ThrudTheBarbarian/xe-host/README.md

# xe-host
T8-based Atari-XE host-interface to XIO
