ThrudTheBarbarian/xe-host/host.brd

## EAGLE design host.brd (2021-09-28)

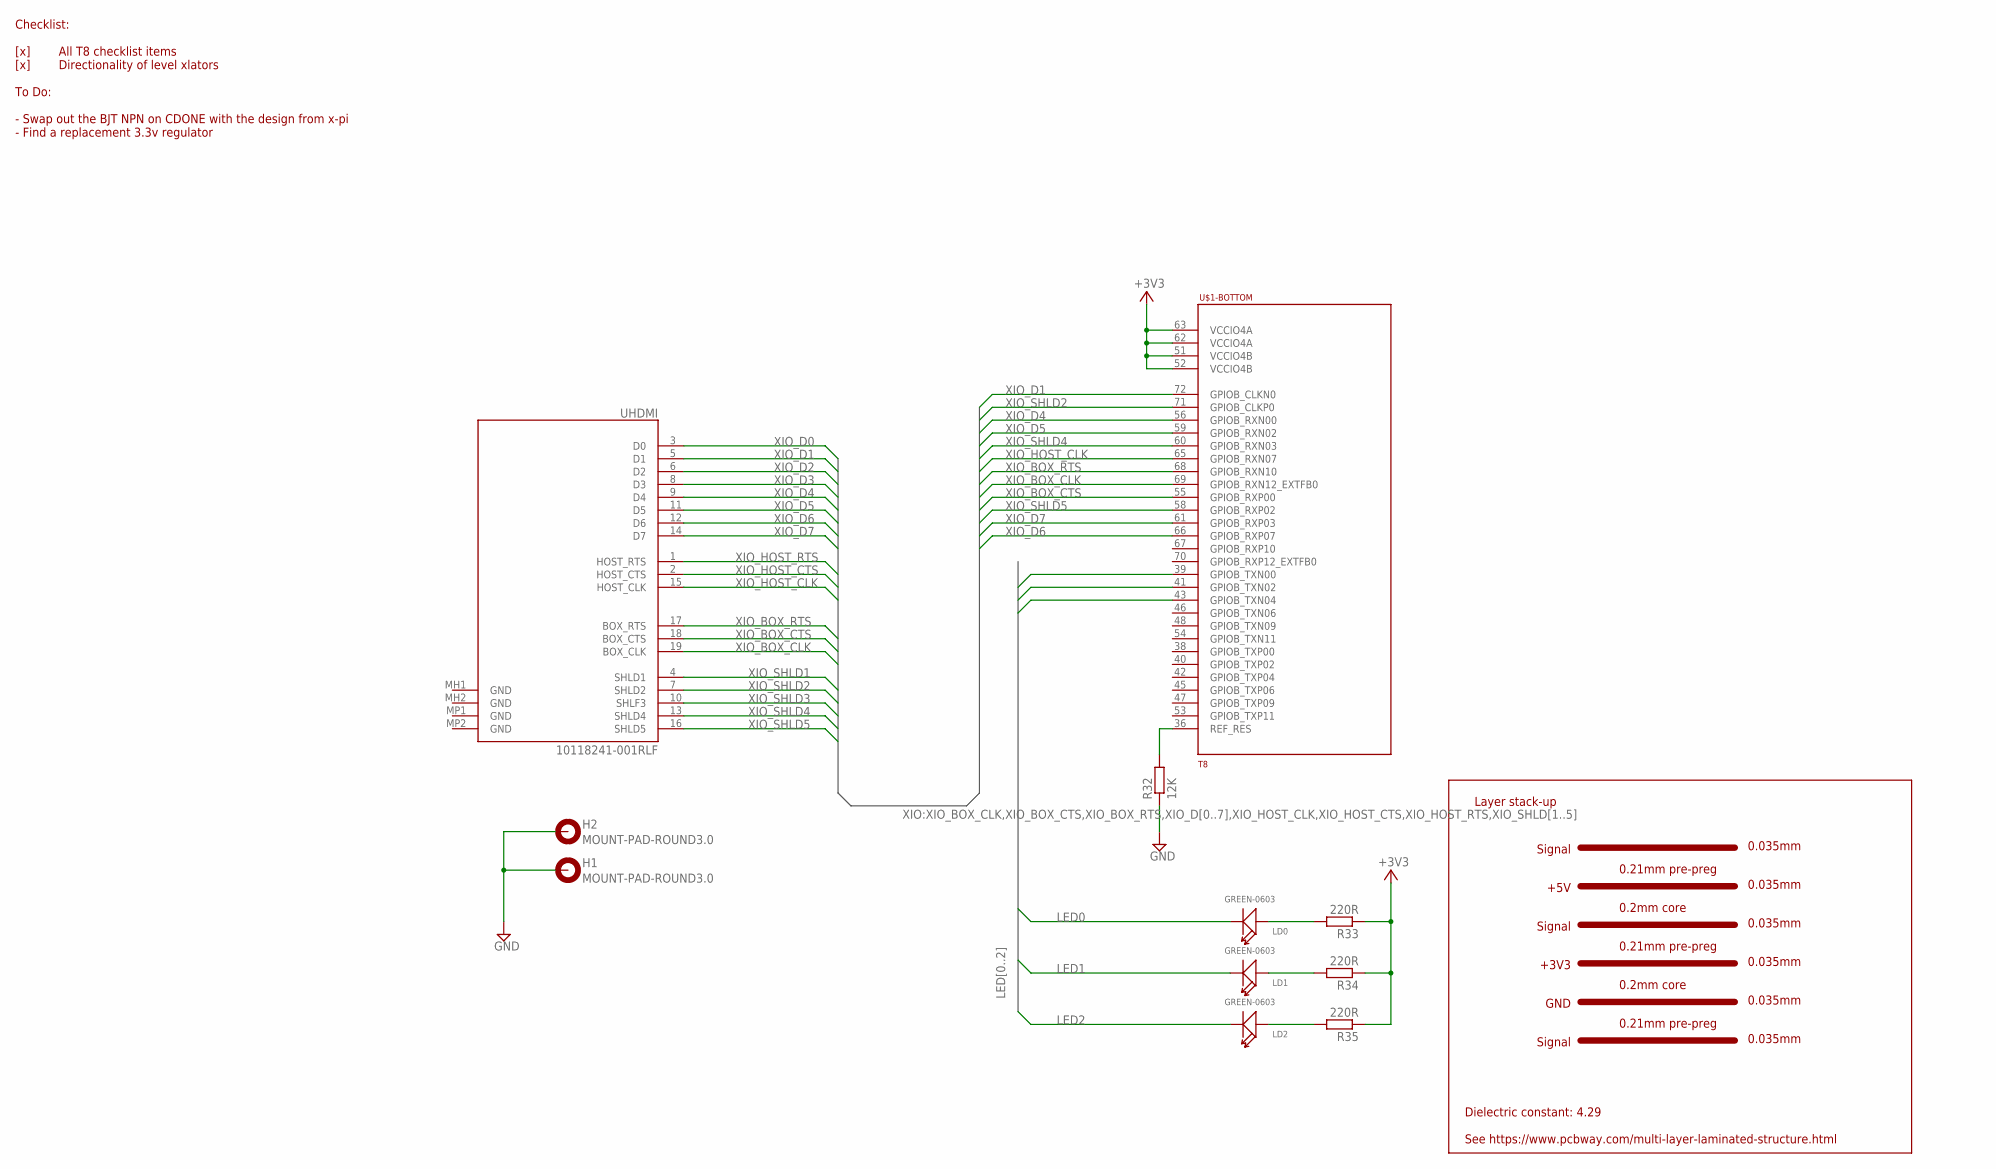
[picture p1: schematic host.sch, sheet 1]

Parts:
H1, H2: MOUNT-PAD-ROUND3.0; 3,0-PAD
LD0, LD1, LD2: GREEN-0603; LED-0603
R32: 12K; R0201
R33, R34, R35: 220R; R0201
U$1: T8; TQFP144
UHDMI: 10118241-001RLF; 10118241001RLF

Connections:
+3V3: R33.1, R34.1, R35.1, U$1.51 (VCCIO4B), U$1.52 (VCCIO4B), U$1.62 (VCCIO4A), U$1.63 (VCCIO4A); also elsewhere on the board
GND: H1.B3,0, H2.B3,0, R32.1; also elsewhere on the board
LED0: LD0.-, U$1.39 (GPIOB_TXN00)
LED1: LD1.-, U$1.41 (GPIOB_TXN02)
LED2: LD2.-, U$1.43 (GPIOB_TXN04)
unnamed: R32.2, U$1.36 (REF_RES)
unnamed: LD0.+, R33.2
unnamed: LD1.+, R34.2
unnamed: LD2.+, R35.2
XIO_BOX_CLK: U$1.69 (GPIOB_RXN12_EXTFB0), UHDMI.19 (BOX_CLK); also elsewhere on the board
XIO_BOX_CTS: U$1.55 (GPIOB_RXP00), UHDMI.18 (BOX_CTS); also elsewhere on the board
XIO_BOX_RTS: U$1.68 (GPIOB_RXN10), UHDMI.17 (BOX_RTS); also elsewhere on the board
XIO_D0: UHDMI.3 (D0); also elsewhere on the board
XIO_D1: U$1.72 (GPIOB_CLKN0), UHDMI.5 (D1); also elsewhere on the board
XIO_D2: UHDMI.6 (D2); also elsewhere on the board
XIO_D3: UHDMI.8 (D3); also elsewhere on the board
XIO_D4: U$1.56 (GPIOB_RXN00), UHDMI.9 (D4); also elsewhere on the board
XIO_D5: U$1.59 (GPIOB_RXN02), UHDMI.11 (D5); also elsewhere on the board
XIO_D6: U$1.66 (GPIOB_RXP07), UHDMI.12 (D6); also elsewhere on the board
XIO_D7: U$1.61 (GPIOB_RXP03), UHDMI.14 (D7); also elsewhere on the board
XIO_HOST_CLK: U$1.65 (GPIOB_RXN07), UHDMI.15 (HOST_CLK); also elsewhere on the board
XIO_HOST_CTS: UHDMI.2 (HOST_CTS); also elsewhere on the board
XIO_HOST_RTS: UHDMI.1 (HOST_RTS); also elsewhere on the board
XIO_SHLD1: UHDMI.4 (SHLD1); also elsewhere on the board
XIO_SHLD2: U$1.71 (GPIOB_CLKP0), UHDMI.7 (SHLD2); also elsewhere on the board
XIO_SHLD3: UHDMI.10 (SHLF3); also elsewhere on the board
XIO_SHLD4: U$1.60 (GPIOB_RXN03), UHDMI.13 (SHLD4); also elsewhere on the board
XIO_SHLD5: U$1.58 (GPIOB_RXP02), UHDMI.16 (SHLD5); also elsewhere on the board

Notes on the sheet:
Checklist: [x] All T8 checklist items [x] Directionality of level xlators To Do: - Swap out the BJT NPN on CDONE with the design from x-pi - Find a replacement 3.3v regulator
0.035mm
Layer stack-up
+3V3
Dielectric constant: 4.29 See https://www.pcbway.com/multi-layer-laminated-structure.html
Signal
GND
Signal
+5V
0.21mm pre-preg
0.2mm core

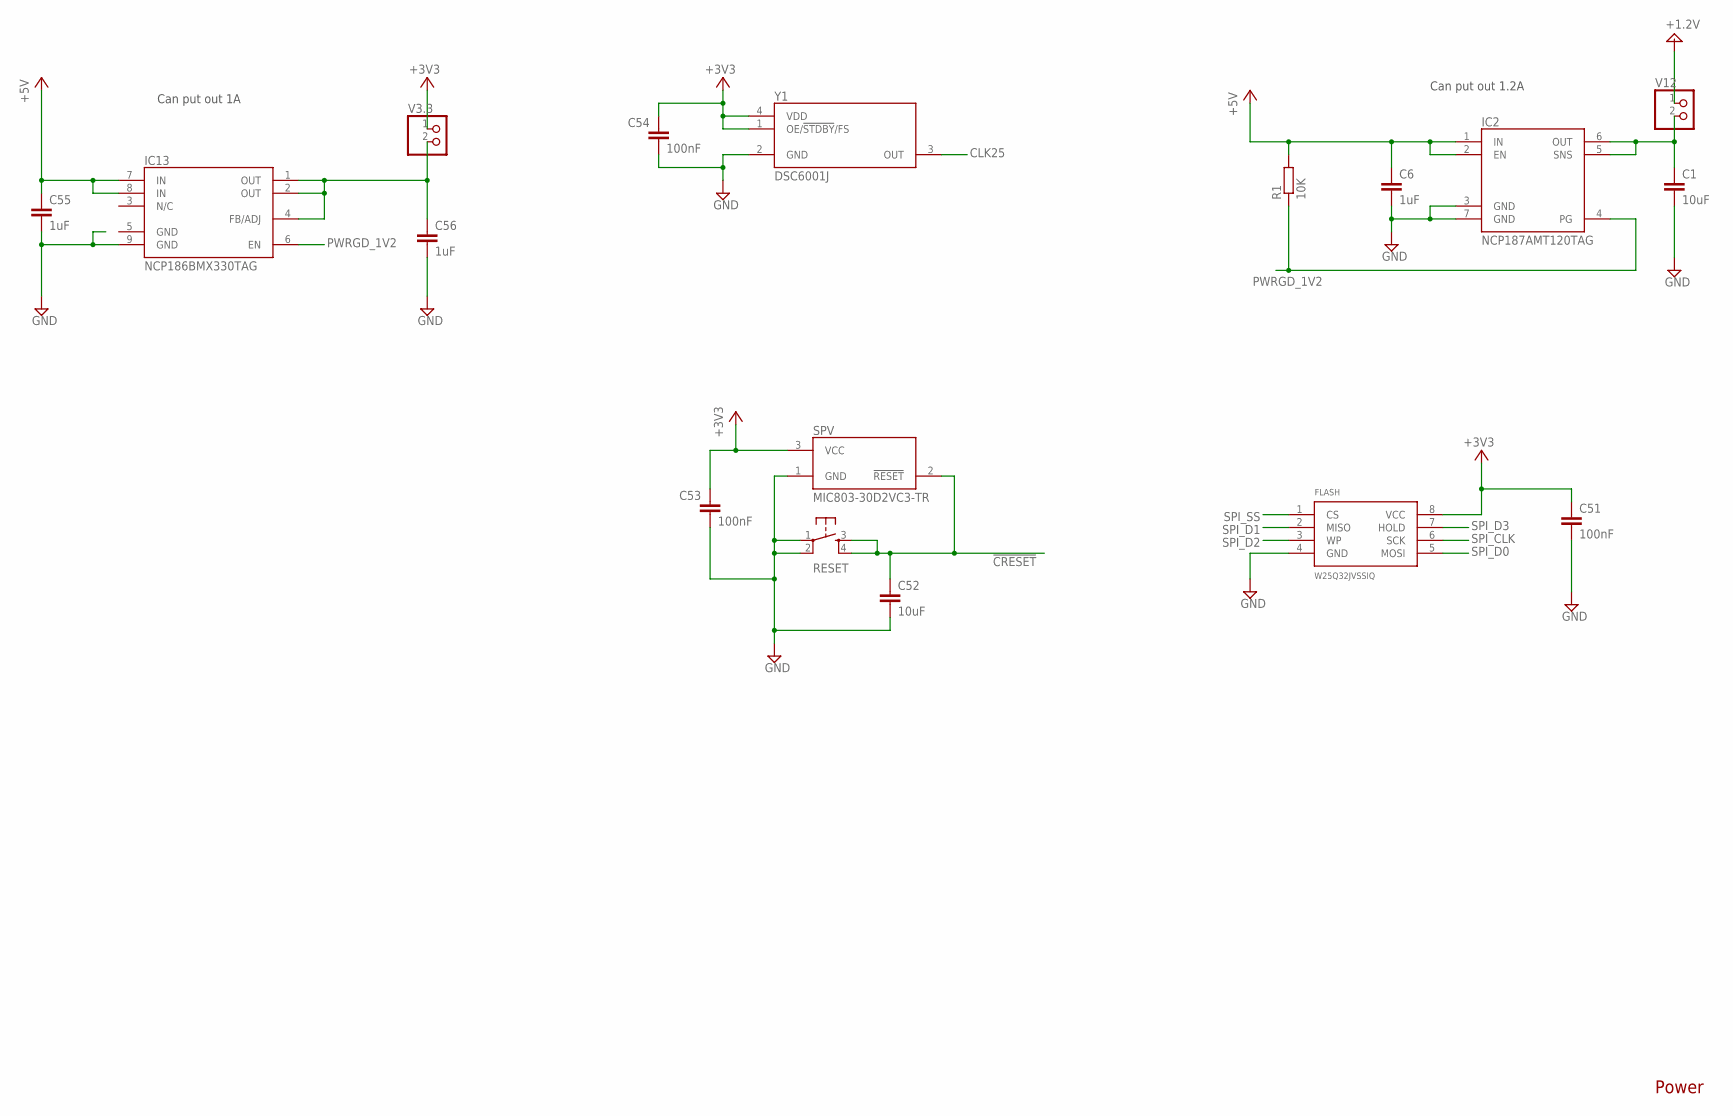
[picture p2: schematic host.sch, sheet 2, Power]

Parts:
C1, C52: 10uF; C0402K
C6, C55, C56: 1uF; C0201
C51, C53, C54: 100nF; C0201
FLASH: W25Q32JVSSIQ; SO08
IC2: NCP187AMT120TAG; SON65P200X200X80-7N
IC13: NCP186BMX330TAG; NCP186AMX330TAG
R1: 10K; R0201
RESET: TAC_SWITCHPTH; TACTILE-PTH
SPV: MIC803-30D2VC3-TR; SOT95P237X111-3N
V3.3, V12: PINHD-1X2; 1X02
Y1: DSC6001J; DSC6001JE2B0240000

Connections:
!CRESET!: C52.1, RESET.3, RESET.4, SPV.2 (!RESET!); also elsewhere on the board
+1.2V: V12.1; also elsewhere on the board
+3V3: C51.1, C53.1, C54.1, FLASH.8 (VCC), SPV.3 (VCC), V3.3.1, Y1.1 (OE/!STDBY!/FS), Y1.4 (VDD); also elsewhere on the board
+5V: C6.1, C55.1, IC2.1 (IN), IC2.2 (EN), IC13.7 (IN), IC13.8 (IN), R1.2; also elsewhere on the board
CLK25: Y1.3 (OUT); also elsewhere on the board
GND: C1.2, C6.2, C51.2, C52.2, C53.2, C54.2, C55.2, C56.2, FLASH.4 (GND), IC2.3 (GND), IC2.7 (GND), IC13.9 (GND), RESET.1, RESET.2, SPV.1 (GND), Y1.2 (GND); also elsewhere on the board
unnamed: C1.1, IC2.5 (SNS), IC2.6 (OUT), V12.2
unnamed: C56.1, IC13.1 (OUT), IC13.2 (OUT), IC13.4 (FB/ADJ), V3.3.2
PWRGD_1V2: IC2.4 (PG), IC13.6 (EN), R1.1
SPI_CLK: FLASH.6 (SCK); also elsewhere on the board
SPI_D0: FLASH.5 (MOSI); also elsewhere on the board
SPI_D1: FLASH.2 (MISO); also elsewhere on the board
SPI_D2: FLASH.3 (WP); also elsewhere on the board
SPI_D3: FLASH.7 (HOLD); also elsewhere on the board
SPI_SS: FLASH.1 (CS); also elsewhere on the board

Notes on the sheet:
Power
Can put out 1.2A
Can put out 1A

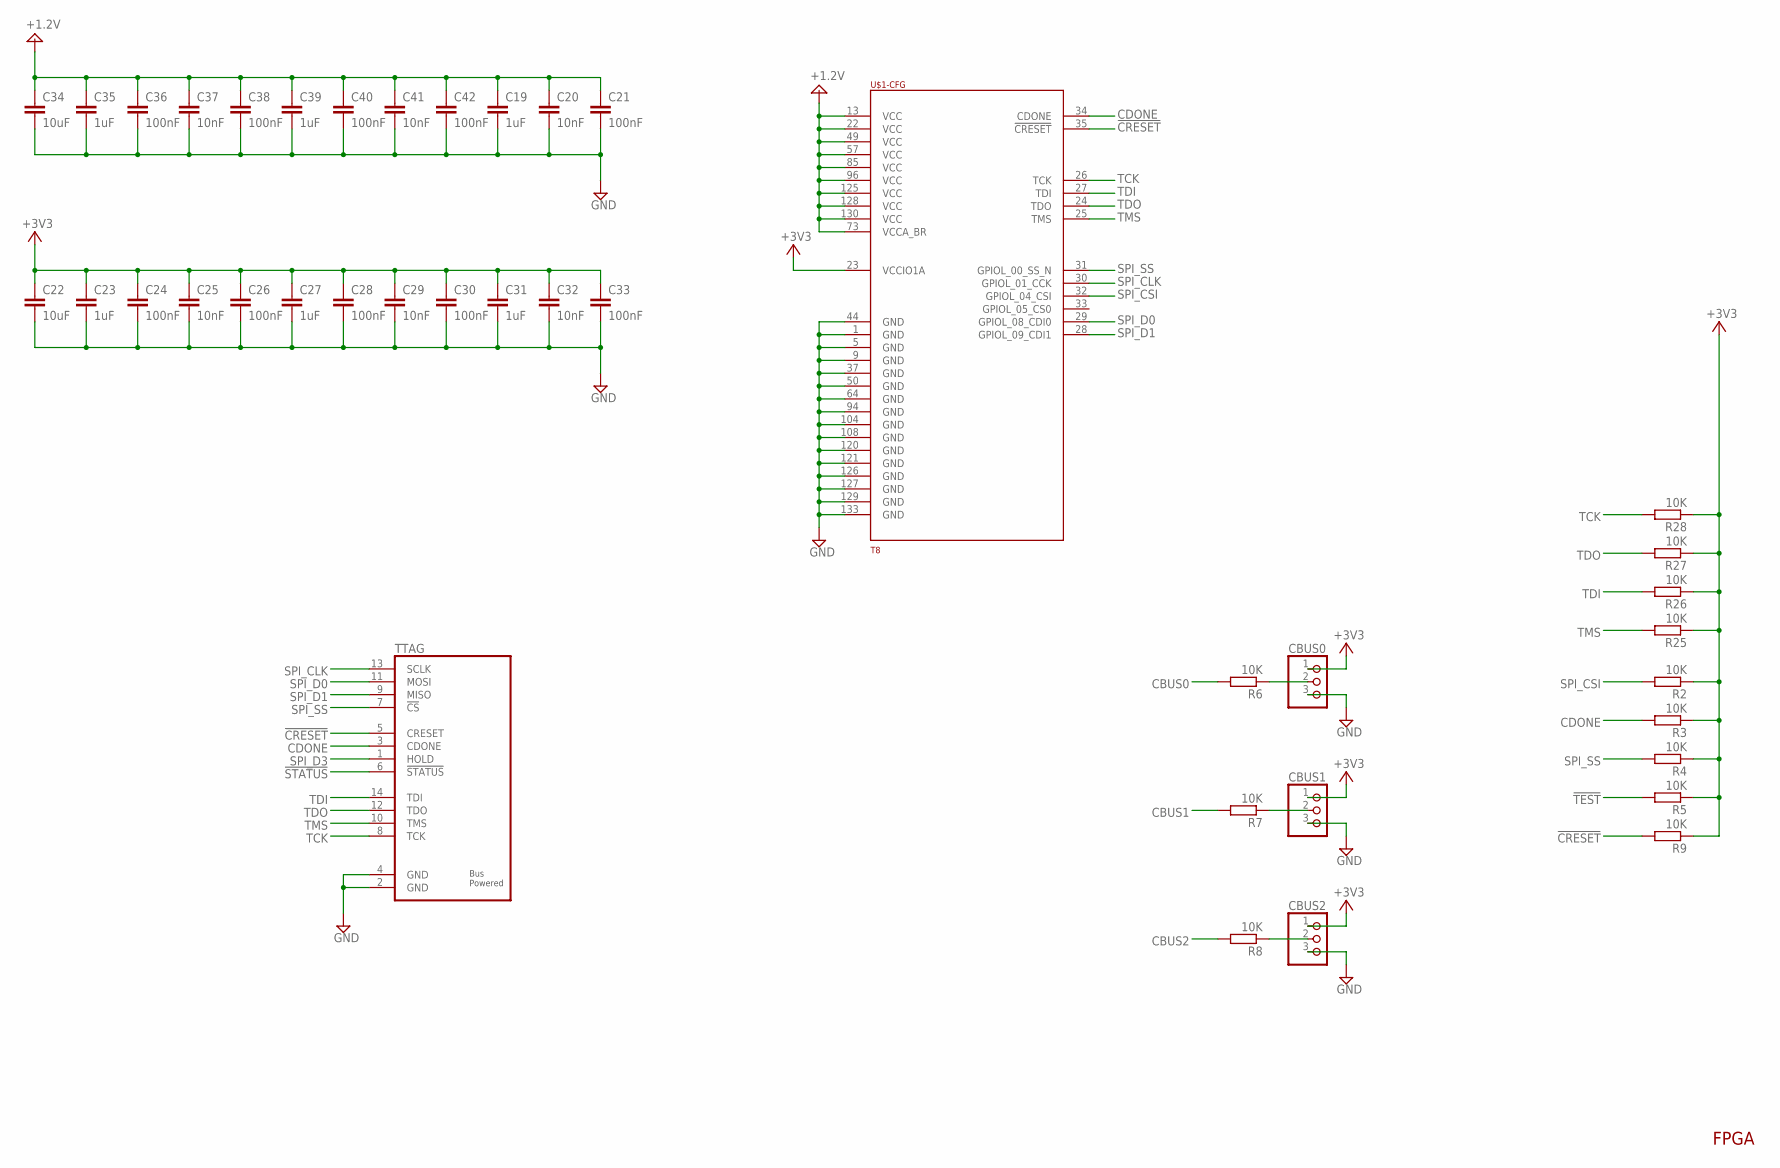
[picture p3: schematic host.sch, sheet 3, FPGA]

Parts:
C19, C23, C27, C31, C35, C39: 1uF; C0201
C20, C25, C29, C32, C37, C41: 10nF; C0201
C21, C24, C26, C28, C30, C33, C36, C38, C40, C42: 100nF; C0201
C22, C34: 10uF; C0402K
CBUS0, CBUS1, CBUS2: PINHD-1X3; 1X03
R2, R3, R4, R5, R6, R7, R8, R9, R25, R26, R27, R28: 10K; R0201
TTAG: TTAG_M_2.00; 2X07M
U$1: T8; TQFP144

Connections:
!CRESET!: R9.2, TTAG.5 (CRESET), U$1.35 (!CRESET!); also elsewhere on the board
!STATUS!: TTAG.6 (!STATUS!); also elsewhere on the board
!TEST!: R5.2; also elsewhere on the board
+1.2V: C19.1, C20.1, C21.1, C34.1, C35.1, C36.1, C37.1, C38.1, C39.1, C40.1, C41.1, C42.1, U$1.13 (VCC), U$1.22 (VCC), U$1.49 (VCC), U$1.57 (VCC), U$1.73 (VCCA_BR), U$1.85 (VCC), U$1.96 (VCC), U$1.125 (VCC), U$1.128 (VCC), U$1.130 (VCC); also elsewhere on the board
+3V3: C22.1, C23.1, C24.1, C25.1, C26.1, C27.1, C28.1, C29.1, C30.1, C31.1, C32.1, C33.1, CBUS0.1, CBUS1.1, CBUS2.1, R2.1, R3.1, R4.1, R5.1, R9.1, R25.1, R26.1, R27.1, R28.1, U$1.23 (VCCIO1A); also elsewhere on the board
CBUS0: R6.2; also elsewhere on the board
CBUS1: R7.2; also elsewhere on the board
CBUS2: R8.2; also elsewhere on the board
CDONE: R3.2, TTAG.3 (CDONE), U$1.34 (CDONE); also elsewhere on the board
GND: C19.2, C20.2, C21.2, C22.2, C23.2, C24.2, C25.2, C26.2, C27.2, C28.2, C29.2, C30.2, C31.2, C32.2, C33.2, C34.2, C35.2, C36.2, C37.2, C38.2, C39.2, C40.2, C41.2, C42.2, CBUS0.3, CBUS1.3, CBUS2.3, TTAG.2 (GND), TTAG.4 (GND), U$1.1 (GND), U$1.5 (GND), U$1.9 (GND), U$1.37 (GND), U$1.44 (GND), U$1.50 (GND), U$1.64 (GND), U$1.94 (GND), U$1.104 (GND), U$1.108 (GND), U$1.120 (GND), U$1.121 (GND), U$1.126 (GND), U$1.127 (GND), U$1.129 (GND), U$1.133 (GND); also elsewhere on the board
unnamed: CBUS0.2, R6.1
unnamed: CBUS1.2, R7.1
unnamed: CBUS2.2, R8.1
SPI_CLK: TTAG.13 (SCLK), U$1.30 (GPIOL_01_CCK); also elsewhere on the board
SPI_CSI: R2.2, U$1.32 (GPIOL_04_CSI)
SPI_D0: TTAG.11 (MOSI), U$1.29 (GPIOL_08_CDI0); also elsewhere on the board
SPI_D1: TTAG.9 (MISO), U$1.28 (GPIOL_09_CDI1); also elsewhere on the board
SPI_D3: TTAG.1 (HOLD); also elsewhere on the board
SPI_SS: R4.2, TTAG.7 (!CS!), U$1.31 (GPIOL_00_SS_N); also elsewhere on the board
TCK: R28.2, TTAG.8 (TCK), U$1.26 (TCK)
TDI: R26.2, TTAG.14 (TDI), U$1.27 (TDI)
TDO: R27.2, TTAG.12 (TDO), U$1.24 (TDO)
TMS: R25.2, TTAG.10 (TMS), U$1.25 (TMS)

Notes on the sheet:
FPGA

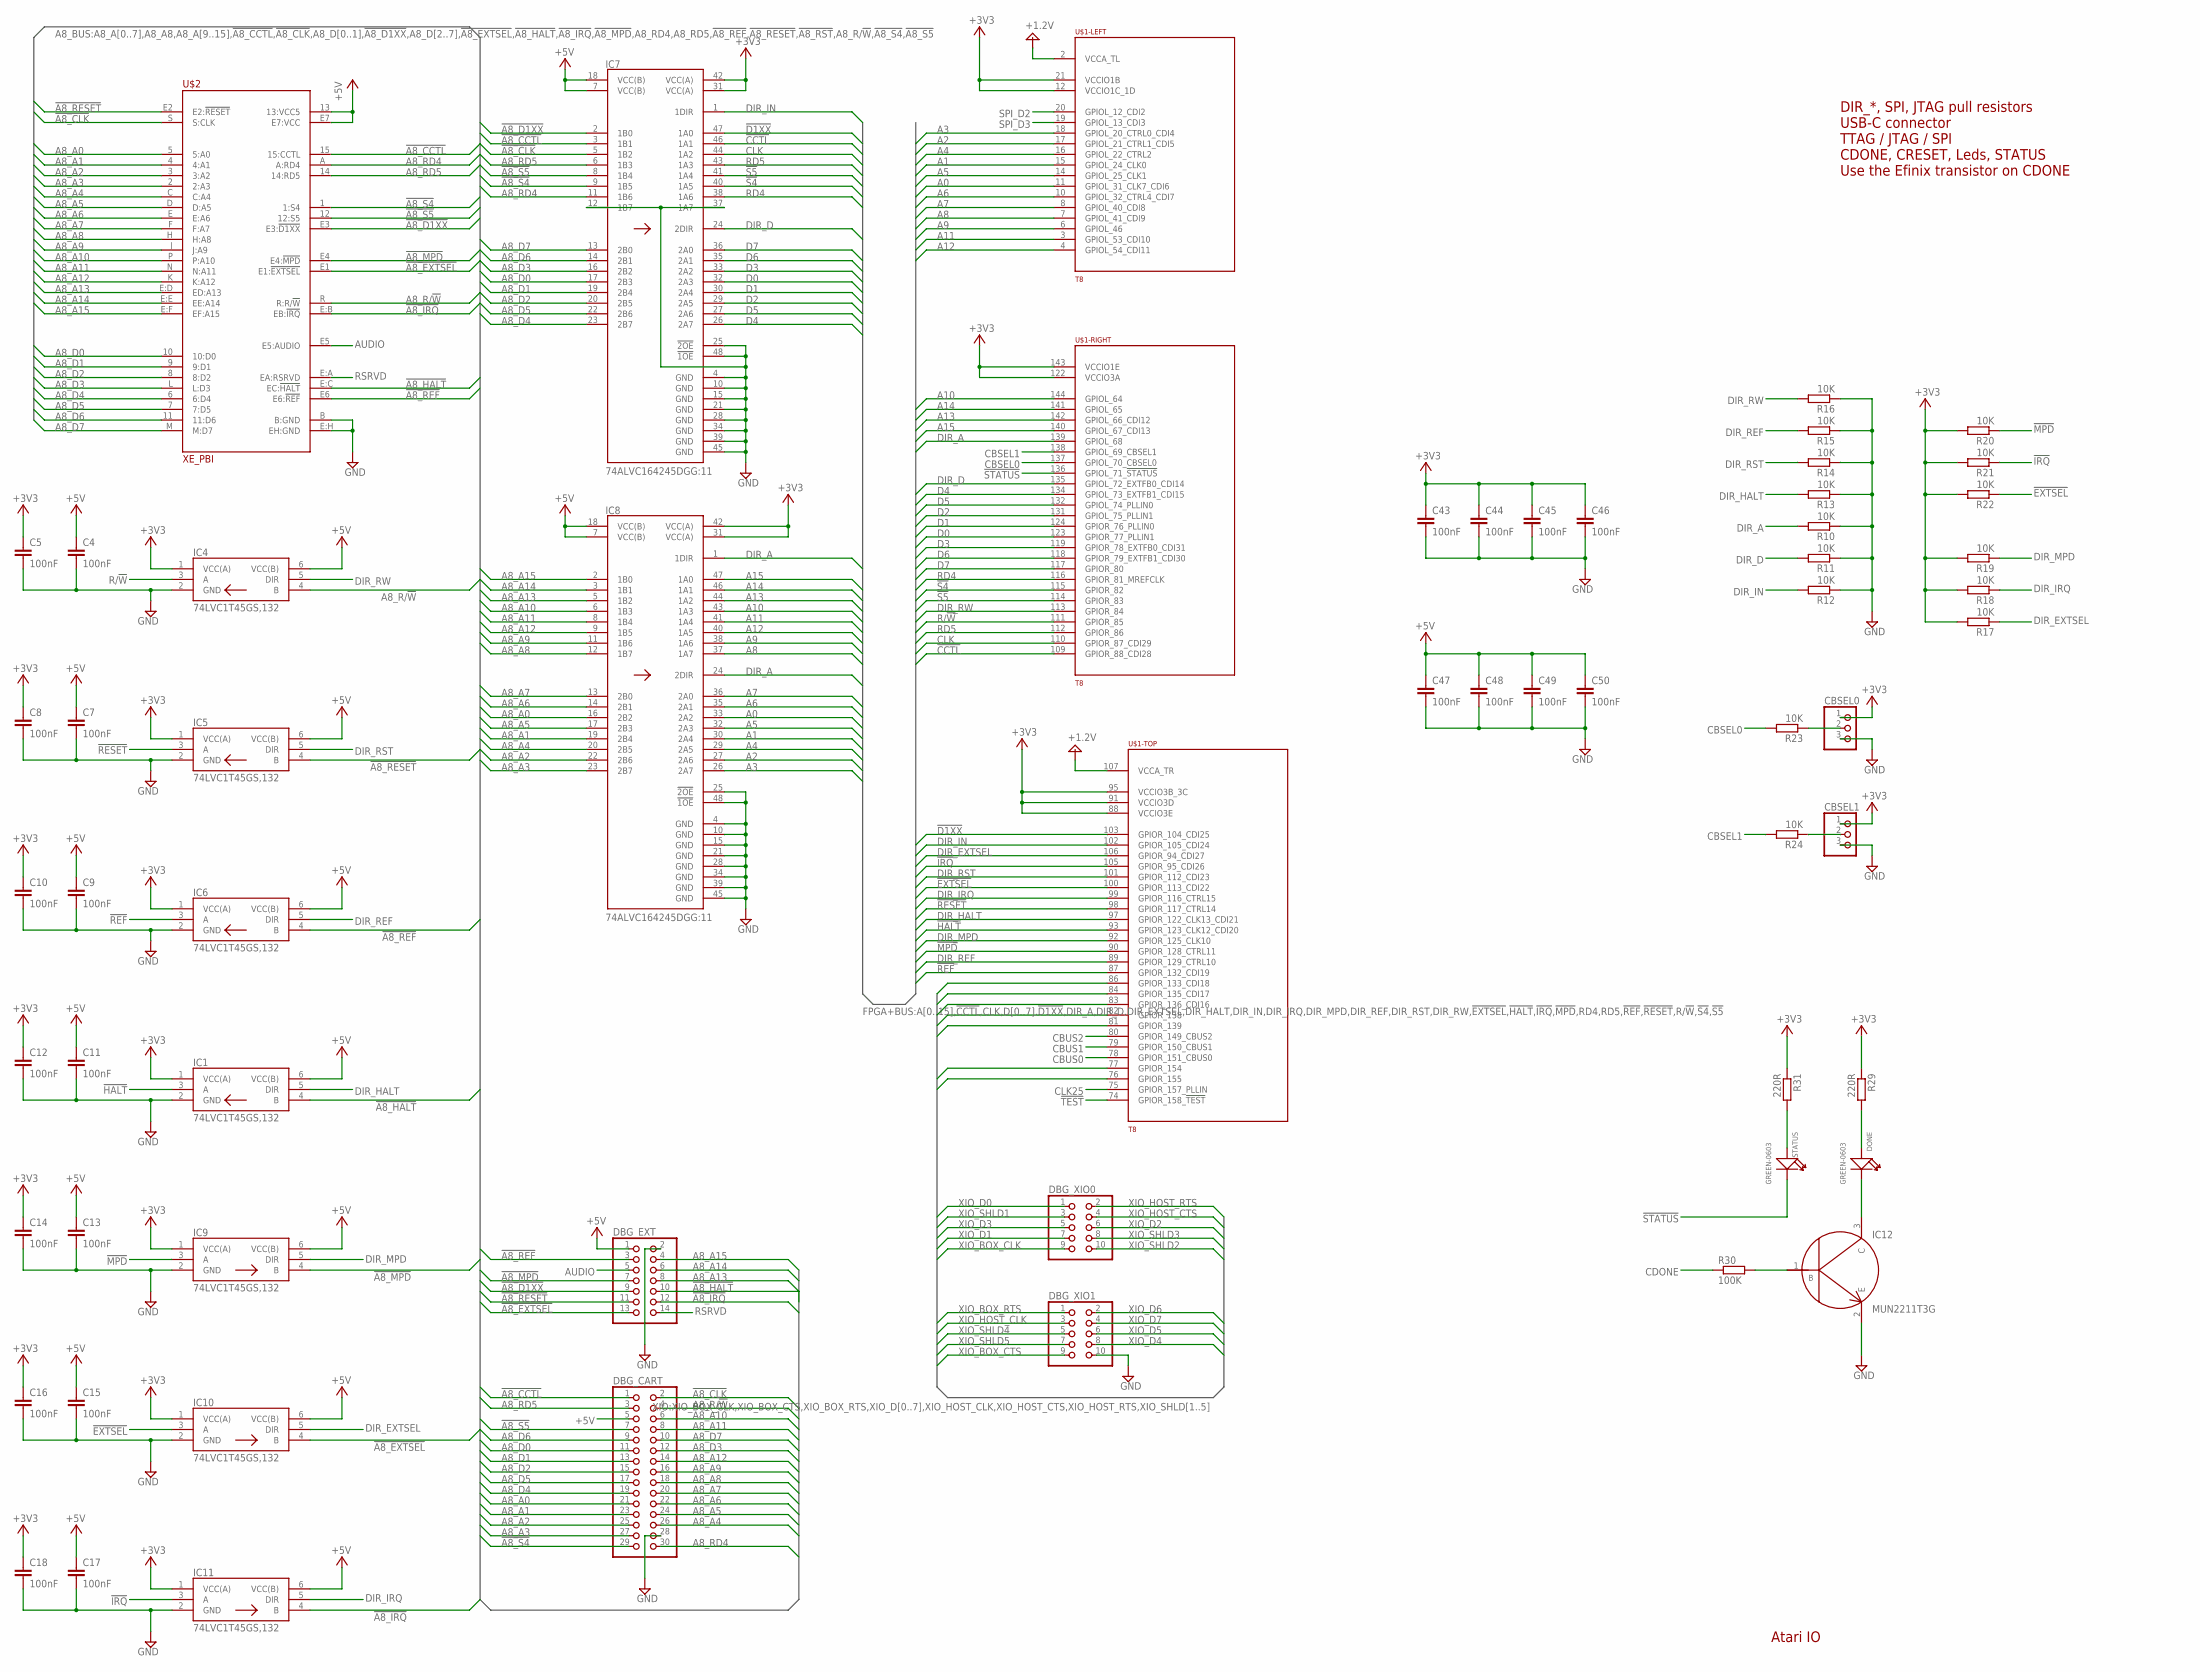
[picture p4: schematic host.sch, sheet 4]

Parts:
C4, C5, C7, C8, C9, C10, C11, C12, C13, C14, C15, C16, C17, C18, C43, C44, C45, C46, C47, C48, C49, C50: 100nF; C0201
CBSEL0, CBSEL1: PINHD-1X3; 1X03
DBG_CART: PINHD-2X15_2.54; 2X15
DBG_EXT: PINHD-2X07_2.54; 2X07
DBG_XIO0, DBG_XIO1: PINHD-2X5; 2X05
DONE: GREEN-0603; LED-0603
IC1, IC4, IC5, IC6, IC9, IC10, IC11: 74LVC1T45GS,132; 74LVC1G3157GS132
IC7, IC8: 74ALVC164245DGG:11; SOP50P810X120-48N
IC12: MUN2211T3G; SOTFL50P160X78-3N
R10, R11, R12, R13, R14, R15, R16, R17, R18, R19, R20, R21, R22, R23, R24: 10K; R0201
R29, R31: 220R; R0201
R30: 100K; R0201
STATUS: GREEN-0603; LED-0603
U$1: T8; TQFP144
U$2: XE_PBI

Connections:
!A8_CCTL!: DBG_CART.1, IC7.3 (1B1), U$2.15 (15:CCTL)
!A8_CLK!: DBG_CART.2, IC7.5 (1B2), U$2.S (S:CLK)
!A8_D1XX!: DBG_EXT.9, IC7.2 (1B0), U$2.E3 (E3:!D1XX!)
!A8_EXTSEL!: DBG_EXT.13, IC10.4 (B), U$2.E1 (E1:!EXTSEL!)
!A8_HALT!: DBG_EXT.10, IC1.4 (B), U$2.E:C (EC:!HALT!)
!A8_IRQ!: DBG_EXT.12, IC11.4 (B), U$2.E:B (EB:!IRQ!)
!A8_MPD!: DBG_EXT.7, IC9.4 (B), U$2.E4 (E4:!MPD!)
!A8_REF!: DBG_EXT.3, IC6.4 (B), U$2.E6 (E6:!REF!)
!A8_RESET!: DBG_EXT.11, IC5.4 (B), U$2.E2 (E2:!RESET!)
!A8_S4!: DBG_CART.29, IC7.9 (1B5), U$2.1 (1:S4)
!A8_S5!: DBG_CART.7, IC7.8 (1B4), U$2.12 (12:S5)
!CCTL!: IC7.46 (1A1), U$1.109 (GPIOR_88_CDI28)
!D1XX!: IC7.47 (1A0), U$1.103 (GPIOR_104_CDI25)
!EXTSEL!: IC10.3 (A), R22.1, U$1.100 (GPIOR_113_CDI22)
!HALT!: IC1.3 (A), U$1.93 (GPIOR_123_CLK12_CDI20)
!IRQ!: IC11.3 (A), R21.1, U$1.105 (GPIOR_95_CDI26)
!MPD!: IC9.3 (A), R20.1, U$1.90 (GPIOR_128_CTRL11)
!REF!: IC6.3 (A), U$1.87 (GPIOR_132_CDI19)
!RESET!: IC5.3 (A), U$1.98 (GPIOR_117_CTRL14)
!S4!: IC7.40 (1A5), U$1.115 (GPIOR_82)
!S5!: IC7.41 (1A4), U$1.114 (GPIOR_83)
!STATUS!: STATUS.-, U$1.136 (GPIOL_71_!STATUS!); also elsewhere on the board
!TEST!: U$1.74 (GPIOR_158_!TEST!); also elsewhere on the board
+1.2V: U$1.2 (VCCA_TL), U$1.107 (VCCA_TR); also elsewhere on the board
+3V3: C5.1, C8.1, C10.1, C12.1, C14.1, C16.1, C18.1, C43.1, C44.1, C45.1, C46.1, CBSEL0.1, CBSEL1.1, IC1.1 (VCC(A)), IC4.1 (VCC(A)), IC5.1 (VCC(A)), IC6.1 (VCC(A)), IC7.31 (VCC(A)), IC7.42 (VCC(A)), IC8.31 (VCC(A)), IC8.42 (VCC(A)), IC9.1 (VCC(A)), IC10.1 (VCC(A)), IC11.1 (VCC(A)), R17.2, R18.2, R19.2, R20.2, R21.2, R22.2, R29.1, R31.1, U$1.12 (VCCIO1C_1D), U$1.21 (VCCIO1B), U$1.88 (VCCIO3E), U$1.91 (VCCIO3D), U$1.95 (VCCIO3B_3C), U$1.122 (VCCIO3A), U$1.143 (VCCIO1E); also elsewhere on the board
+5V: C4.1, C7.1, C9.1, C11.1, C13.1, C15.1, C17.1, C47.1, C48.1, C49.1, C50.1, DBG_CART.5, DBG_EXT.1, IC1.6 (VCC(B)), IC4.6 (VCC(B)), IC5.6 (VCC(B)), IC6.6 (VCC(B)), IC7.7 (VCC(B)), IC7.18 (VCC(B)), IC8.7 (VCC(B)), IC8.18 (VCC(B)), IC9.6 (VCC(B)), IC10.6 (VCC(B)), IC11.6 (VCC(B)), U$2.13 (13:VCC5), U$2.E7 (E7:VCC); also elsewhere on the board
A0: IC8.33 (2A2), U$1.11 (GPIOL_31_CLK7_CDI6)
A1: IC8.30 (2A4), U$1.15 (GPIOL_24_CLK0)
A2: IC8.27 (2A6), U$1.17 (GPIOL_21_CTRL1_CDI5)
A3: IC8.26 (2A7), U$1.18 (GPIOL_20_CTRL0_CDI4)
A4: IC8.29 (2A5), U$1.16 (GPIOL_22_CTRL2)
A5: IC8.32 (2A3), U$1.14 (GPIOL_25_CLK1)
A6: IC8.35 (2A1), U$1.10 (GPIOL_32_CTRL4_CDI7)
A7: IC8.36 (2A0), U$1.8 (GPIOL_40_CDI8)
A8: IC8.37 (1A7), U$1.7 (GPIOL_41_CDI9)
A8_A0: DBG_CART.21, IC8.16 (2B2), U$2.5 (5:A0)
A8_A1: DBG_CART.23, IC8.19 (2B4), U$2.4 (4:A1)
A8_A2: DBG_CART.25, IC8.22 (2B6), U$2.3 (3:A2)
A8_A3: DBG_CART.27, IC8.23 (2B7), U$2.2 (2:A3)
A8_A4: DBG_CART.26, IC8.20 (2B5), U$2.C (C:A4)
A8_A5: DBG_CART.24, IC8.17 (2B3), U$2.D (D:A5)
A8_A6: DBG_CART.22, IC8.14 (2B1), U$2.E (E:A6)
A8_A7: DBG_CART.20, IC8.13 (2B0), U$2.F (F:A7)
A8_A8: DBG_CART.18, IC8.12 (1B7), U$2.H (H:A8)
A8_A9: DBG_CART.16, IC8.11 (1B6), U$2.J (J:A9)
A8_A10: DBG_CART.6, IC8.6 (1B3), U$2.P (P:A10)
A8_A11: DBG_CART.8, IC8.8 (1B4), U$2.N (N:A11)
A8_A12: DBG_CART.14, IC8.9 (1B5), U$2.K (K:A12)
A8_A13: DBG_EXT.8, IC8.5 (1B2), U$2.E:D (ED:A13)
A8_A14: DBG_EXT.6, IC8.3 (1B1), U$2.E:E (EE:A14)
A8_A15: DBG_EXT.4, IC8.2 (1B0), U$2.E:F (EF:A15)
A8_D0: DBG_CART.11, IC7.17 (2B3), U$2.10 (10:D0)
A8_D1: DBG_CART.13, IC7.19 (2B4), U$2.9 (9:D1)
A8_D2: DBG_CART.15, IC7.20 (2B5), U$2.8 (8:D2)
A8_D3: DBG_CART.12, IC7.16 (2B2), U$2.L (L:D3)
A8_D4: DBG_CART.19, IC7.23 (2B7), U$2.6 (6:D4)
A8_D5: DBG_CART.17, IC7.22 (2B6), U$2.7 (7:D5)
A8_D6: DBG_CART.9, IC7.14 (2B1), U$2.11 (11:D6)
A8_D7: DBG_CART.10, IC7.13 (2B0), U$2.M (M:D7)
A8_R/!W!: DBG_CART.4, IC4.4 (B), U$2.R (R:R/!W!)
A8_RD4: DBG_CART.30, IC7.11 (1B6), U$2.A (A:RD4)
A8_RD5: DBG_CART.3, IC7.6 (1B3), U$2.14 (14:RD5)
A9: IC8.38 (1A6), U$1.6 (GPIOL_46)
A10: IC8.43 (1A3), U$1.144 (GPIOL_64)
A11: IC8.41 (1A4), U$1.3 (GPIOL_53_CDI10)
A12: IC8.40 (1A5), U$1.4 (GPIOL_54_CDI11)
A13: IC8.44 (1A2), U$1.142 (GPIOL_66_CDI12)
A14: IC8.46 (1A1), U$1.141 (GPIOL_65)
A15: IC8.47 (1A0), U$1.140 (GPIOL_67_CDI13)
AUDIO: DBG_EXT.5, U$2.E5 (E5:AUDIO)
CBSEL0: R23.2, U$1.137 (GPIOL_70_CBSEL0)
CBSEL1: R24.2, U$1.138 (GPIOL_69_CBSEL1)
CBUS0: U$1.78 (GPIOR_151_CBUS0); also elsewhere on the board
CBUS1: U$1.79 (GPIOR_150_CBUS1); also elsewhere on the board
CBUS2: U$1.80 (GPIOR_149_CBUS2); also elsewhere on the board
CDONE: R30.1; also elsewhere on the board
CLK: IC7.44 (1A2), U$1.110 (GPIOR_87_CDI29)
CLK25: U$1.75 (GPIOR_157_PLLIN); also elsewhere on the board
D0: IC7.32 (2A3), U$1.123 (GPIOR_77_PLLIN1)
D1: IC7.30 (2A4), U$1.124 (GPIOR_76_PLLIN0)
D2: IC7.29 (2A5), U$1.131 (GPIOL_75_PLLIN1)
D3: IC7.33 (2A2), U$1.119 (GPIOR_78_EXTFB0_CDI31)
D4: IC7.26 (2A7), U$1.134 (GPIOL_73_EXTFB1_CDI15)
D5: IC7.27 (2A6), U$1.132 (GPIOL_74_PLLIN0)
D6: IC7.35 (2A1), U$1.118 (GPIOR_79_EXTFB1_CDI30)
D7: IC7.36 (2A0), U$1.117 (GPIOR_80)
DIR_A: IC8.1 (1DIR), IC8.24 (2DIR), R10.2, U$1.139 (GPIOL_68)
DIR_D: IC7.24 (2DIR), R11.2, U$1.135 (GPIOL_72_EXTFB0_CDI14)
DIR_EXTSEL: IC10.5 (DIR), R17.1, U$1.106 (GPIOR_94_CDI27)
DIR_HALT: IC1.5 (DIR), R13.2, U$1.97 (GPIOR_122_CLK13_CDI21)
DIR_IN: IC7.1 (1DIR), R12.2, U$1.102 (GPIOR_105_CDI24)
DIR_IRQ: IC11.5 (DIR), R18.1, U$1.99 (GPIOR_116_CTRL15)
DIR_MPD: IC9.5 (DIR), R19.1, U$1.92 (GPIOR_125_CLK10)
DIR_REF: IC6.5 (DIR), R15.2, U$1.89 (GPIOR_129_CTRL10)
DIR_RST: IC5.5 (DIR), R14.2, U$1.101 (GPIOR_112_CDI23)
DIR_RW: IC4.5 (DIR), R16.2, U$1.113 (GPIOR_84)
GND: C4.2, C5.2, C7.2, C8.2, C9.2, C10.2, C11.2, C12.2, C13.2, C14.2, C15.2, C16.2, C17.2, C18.2, C43.2, C44.2, C45.2, C46.2, C47.2, C48.2, C49.2, C50.2, CBSEL0.3, CBSEL1.3, DBG_CART.28, DBG_EXT.2, DBG_XIO1.10, IC1.2 (GND), IC4.2 (GND), IC5.2 (GND), IC6.2 (GND), IC7.4 (GND), IC7.10 (GND), IC7.12 (1B7), IC7.15 (GND), IC7.21 (GND), IC7.25 (!2OE), IC7.28 (GND), IC7.34 (GND), IC7.37 (1A7), IC7.39 (GND), IC7.45 (GND), IC7.48 (!1OE), IC8.4 (GND), IC8.10 (GND), IC8.15 (GND), IC8.21 (GND), IC8.25 (!2OE), IC8.28 (GND), IC8.34 (GND), IC8.39 (GND), IC8.45 (GND), IC8.48 (!1OE), IC9.2 (GND), IC10.2 (GND), IC11.2 (GND), IC12.2 (E), R10.1, R11.1, R12.1, R13.1, R14.1, R15.1, R16.1, U$2.B (B:GND), U$2.E:H (EH:GND); also elsewhere on the board
unnamed: CBSEL0.2, R23.1
unnamed: CBSEL1.2, R24.1
unnamed: IC12.1 (B), R30.2
unnamed: DONE.-, IC12.3 (C)
unnamed: DONE.+, R29.2
unnamed: R31.2, STATUS.+
R/!W!: IC4.3 (A), U$1.111 (GPIOR_85)
RD4: IC7.38 (1A6), U$1.116 (GPIOR_81_MREFCLK)
RD5: IC7.43 (1A3), U$1.112 (GPIOR_86)
RSRVD: DBG_EXT.14, U$2.E:A (EA:RSRVD)
SPI_D2: U$1.20 (GPIOL_12_CDI2); also elsewhere on the board
SPI_D3: U$1.19 (GPIOL_13_CDI3); also elsewhere on the board
XIO_BOX_CLK: DBG_XIO0.9; also elsewhere on the board
XIO_BOX_CTS: DBG_XIO1.9; also elsewhere on the board
XIO_BOX_RTS: DBG_XIO1.1; also elsewhere on the board
XIO_D0: DBG_XIO0.1, U$1.84 (GPIOR_135_CDI17); also elsewhere on the board
XIO_D1: DBG_XIO0.7; also elsewhere on the board
XIO_D2: DBG_XIO0.6, U$1.81 (GPIOR_139); also elsewhere on the board
XIO_D3: DBG_XIO0.5, U$1.77 (GPIOR_154); also elsewhere on the board
XIO_D4: DBG_XIO1.8; also elsewhere on the board
XIO_D5: DBG_XIO1.6; also elsewhere on the board
XIO_D6: DBG_XIO1.2; also elsewhere on the board
XIO_D7: DBG_XIO1.4; also elsewhere on the board
XIO_HOST_CLK: DBG_XIO1.3; also elsewhere on the board
XIO_HOST_CTS: DBG_XIO0.4, U$1.83 (GPIOR_136_CDI16); also elsewhere on the board
XIO_HOST_RTS: DBG_XIO0.2, U$1.86 (GPIOR_133_CDI18); also elsewhere on the board
XIO_SHLD1: DBG_XIO0.3, U$1.82 (GPIOR_138); also elsewhere on the board
XIO_SHLD2: DBG_XIO0.10; also elsewhere on the board
XIO_SHLD3: DBG_XIO0.8, U$1.76 (GPIOR_155); also elsewhere on the board
XIO_SHLD4: DBG_XIO1.5; also elsewhere on the board
XIO_SHLD5: DBG_XIO1.7; also elsewhere on the board

Notes on the sheet:
Atari IO
DIR_*, SPI, JTAG pull resistors USB-C connector TTAG / JTAG / SPI CDONE, CRESET, Leds, STATUS Use the Efinix transistor on CDONE

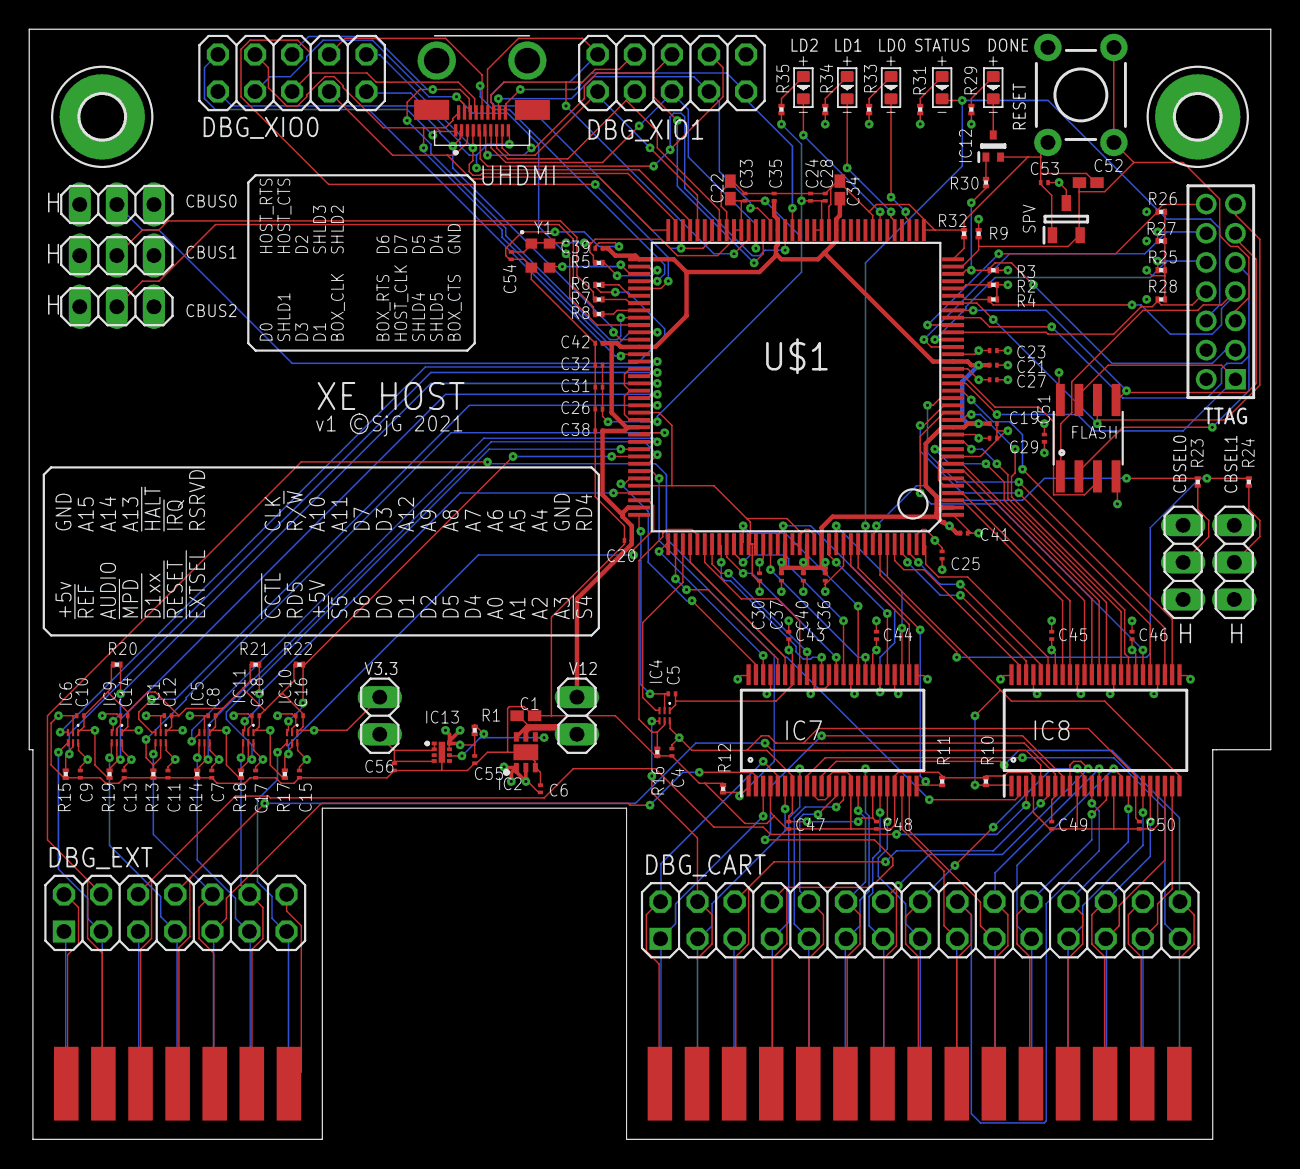
[picture p5: board host.brd from above]

Board: 4 copper layers, 85.0 x 76.0 mm, 127 parts (0 on the bottom side), 151 nets.
