ThrudTheBarbarian/xe-host/(commit log)

2021-09-22 initial import
    [host.brd, host.sch]
2021-09-22 Add the level changes (mostly, still need decoupling and connection to FPGA)
    [host.brd, host.sch]
2021-09-23 Move to 6-layer board for supply cleanliness
    [host.brd, host.sch]
2021-09-23 Hook up the level-translators to the FPGA
    [host.brd, host.sch]
2021-09-23 Add FPGA decoupling caps
    [host.brd, host.sch]
2021-09-23 Add level-translation decoupling caps
    [host.brd, host.sch]
2021-09-24 Working through the design-guide
    [host.brd, host.sch]
2021-09-24 Move to micro-HDMI for the interconnect cable
    [host.brd, host.sch]
2021-09-25 Add in the debug headers
    [host.brd, host.csv, host.sch]
2021-09-25 Running through the checklist
    [host.brd, host.sch]
2021-09-25 Add the micro-HDMI interface
    [host.brd, host.sch]
2021-09-28 Change to available parts
    [host.brd, host.csv, host.sch]
2021-09-28 Using only 4 layers
    [host.brd, host.sch]
