ThrudTheBarbarian/xe-host/(notices)

Notices in the files:
host.brd:
v1 ©SjG 2021
parts and their libraries:
SparkFun: Licensing: CC v3.0 Share-Alike You are welcome to use this library for commercial purposes.
